adhitthan18/Smart-room-monitor/Prototype-SmartRoom.jpeg

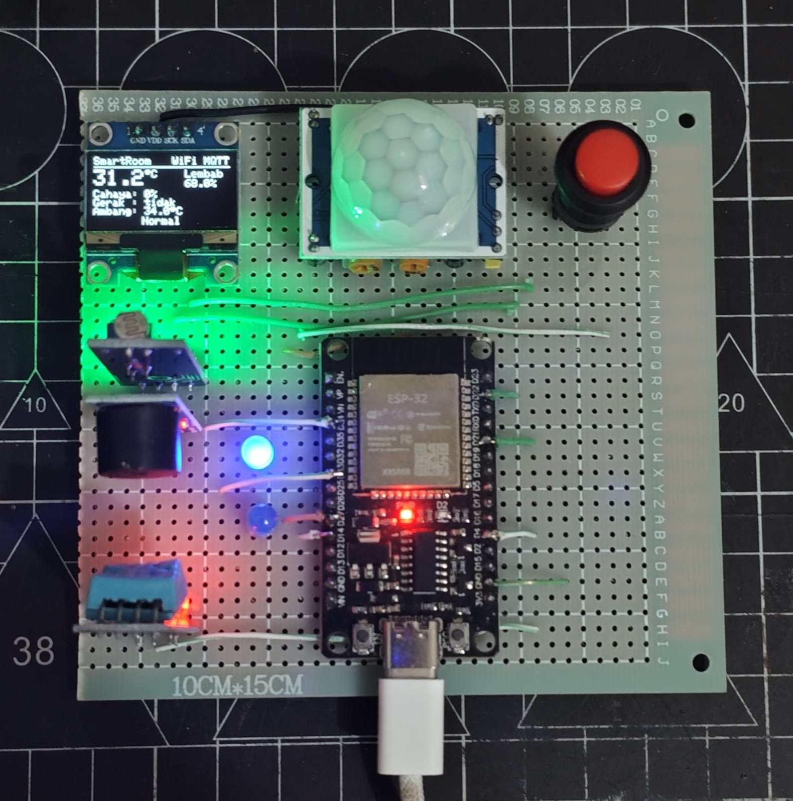
Prototype-SmartRoom.jpeg
