adhitthan18/Smart-room-monitor/PCB-BottomLayer.png

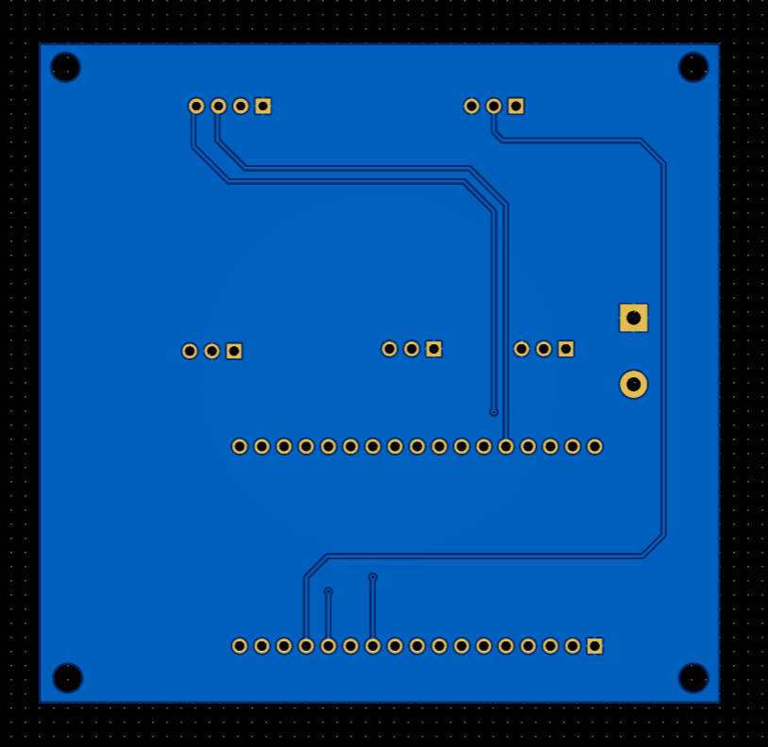
PCB-BottomLayer.png
