adhitthan18/Smart-room-monitor/PCB-TopLayer.png

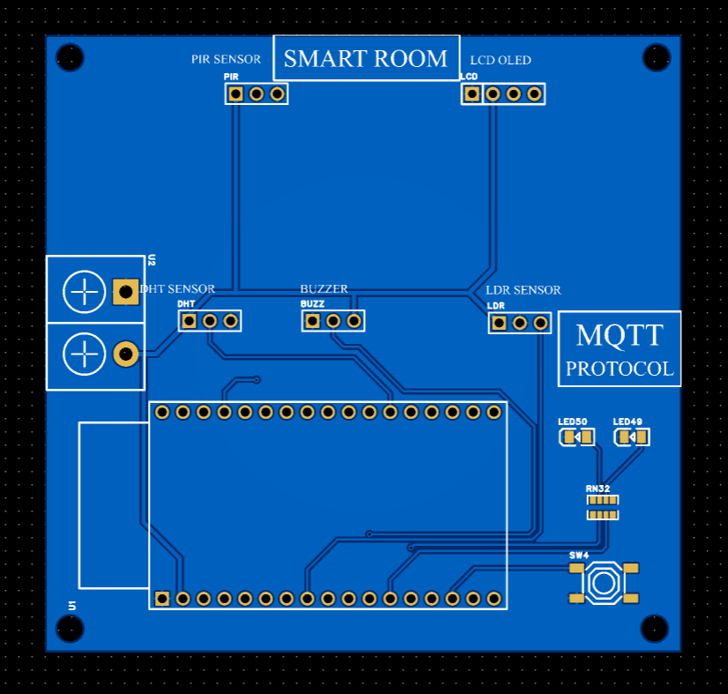
PCB-TopLayer.png
