adhitthan18/Smart-room-monitor/Pengaturan.png

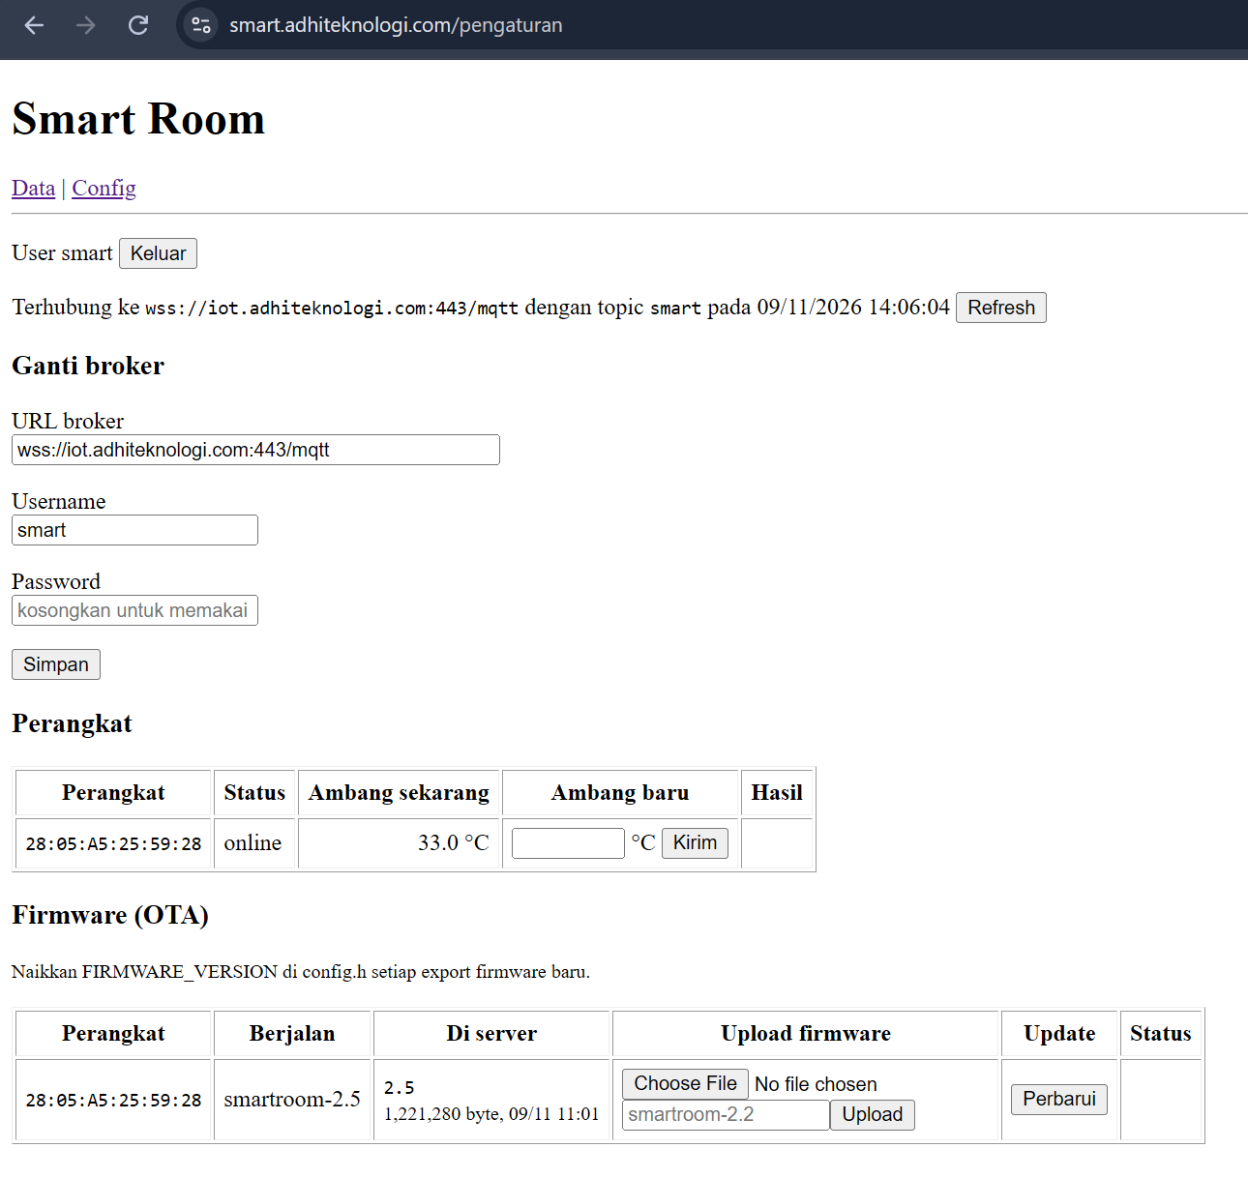
Pengaturan.png
