adhitthan18/Smart-room-monitor/Schematic.png

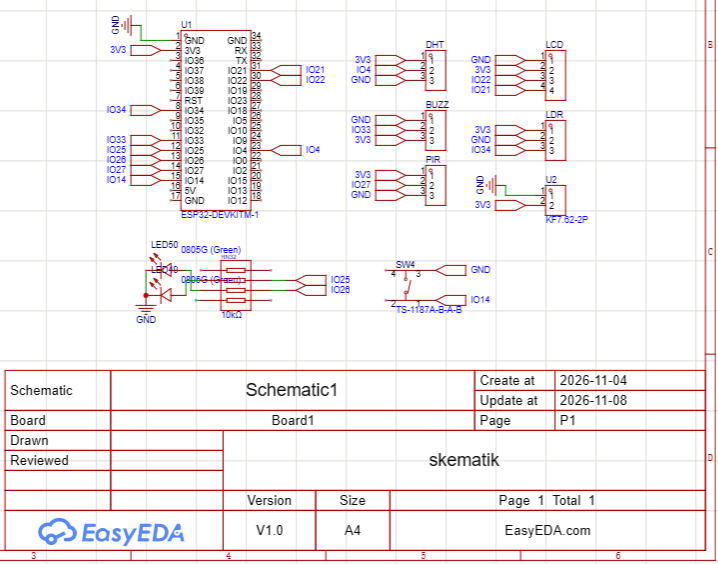
Schematic.png
