adhitthan18/Smart-room-monitor/Utama.png

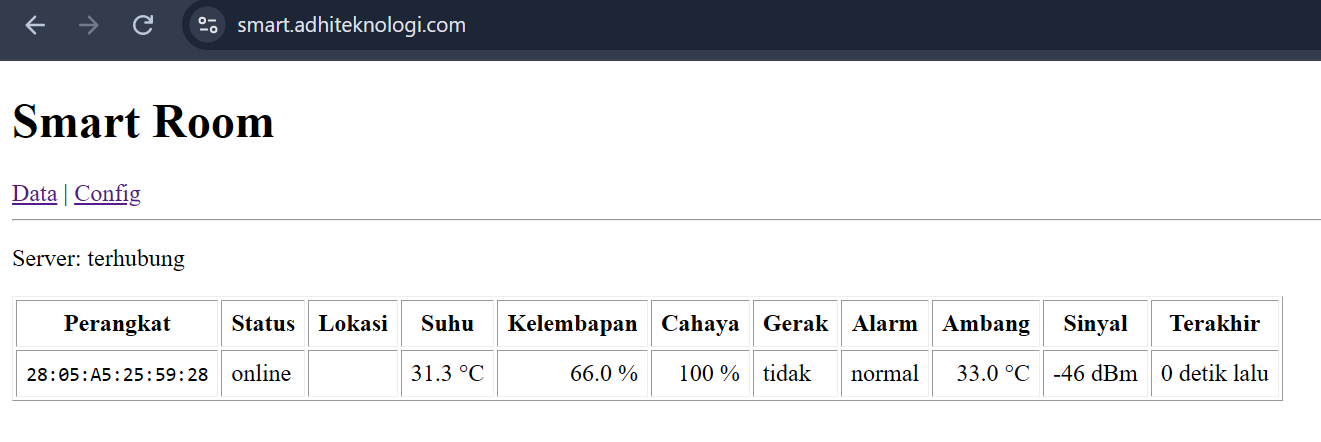
Utama.png
