adhitthan18/Smart-room-monitor/firmware/smartroom/secrets.h

#pragma once

#define WIFI_SSID     "TP-Link"
#define WIFI_PASSWORD "11081828"
#define MQTT_URL      "wss://iot.adhiteknologi.com:443/mqtt"
#define MQTT_USERNAME "smart"
#define MQTT_PASSWORD "-xMdSj1_d0DX2ABLx7sHFOfIZyFsdYr6"
#define HTTP_URL      "https://smart.adhiteknologi.com"
